rolfz/PICSTAR/Doc/block_diag.jpg

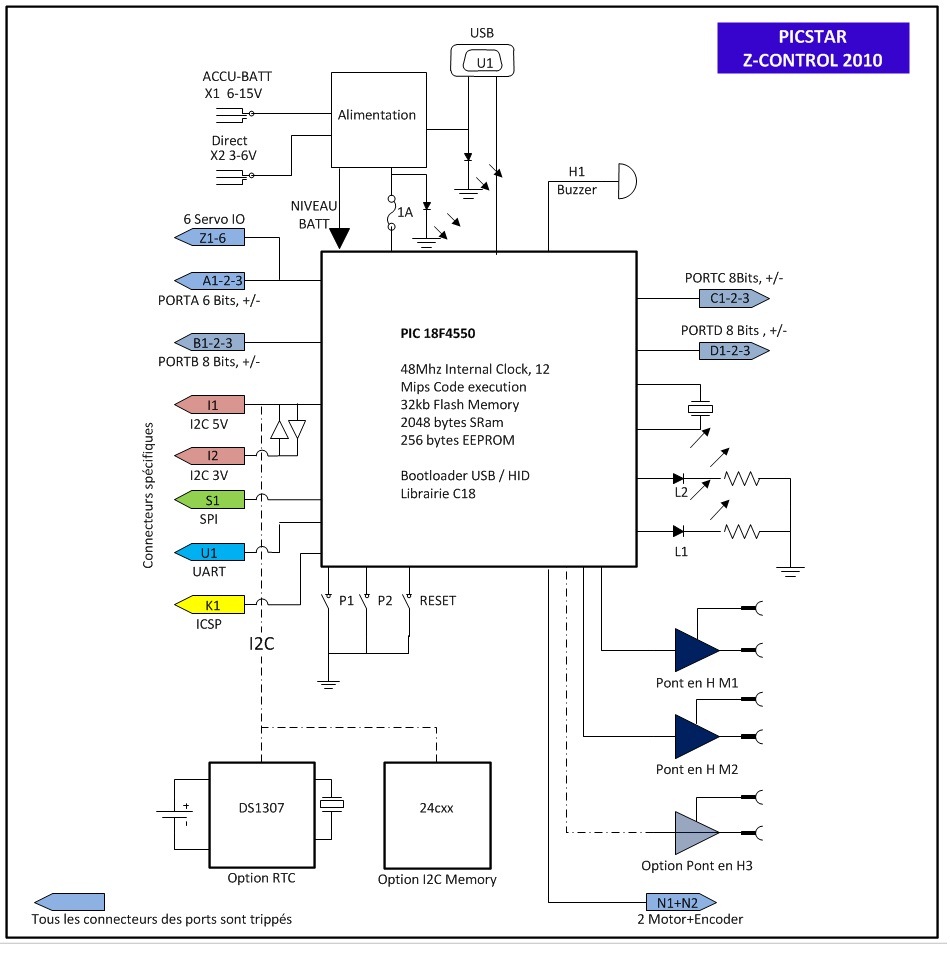
Doc/block_diag.jpg
