rolfz/PICSTAR/Examples/10. RC5 example/RC5_scan.jpg

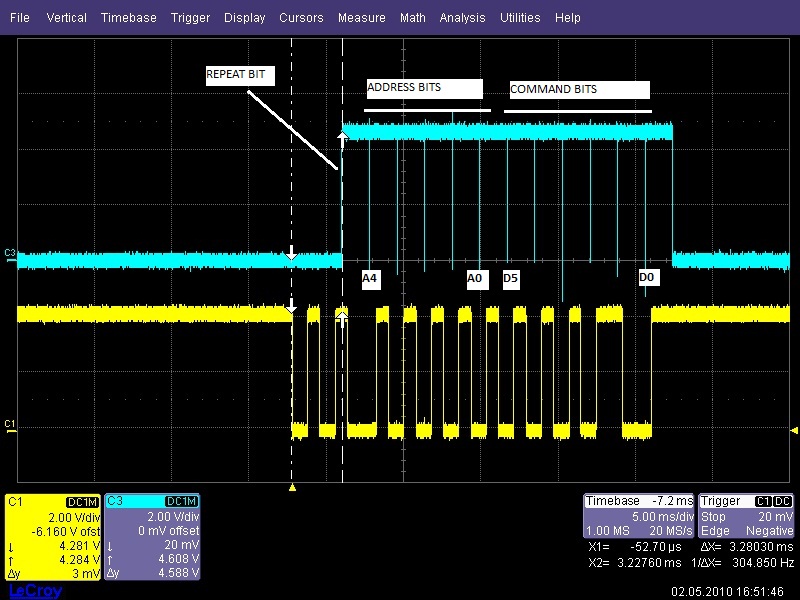
Examples/10. RC5 example/RC5_scan.jpg
