rolfz/PICSTAR/Doc/picstar_schema_det1.1.pdf

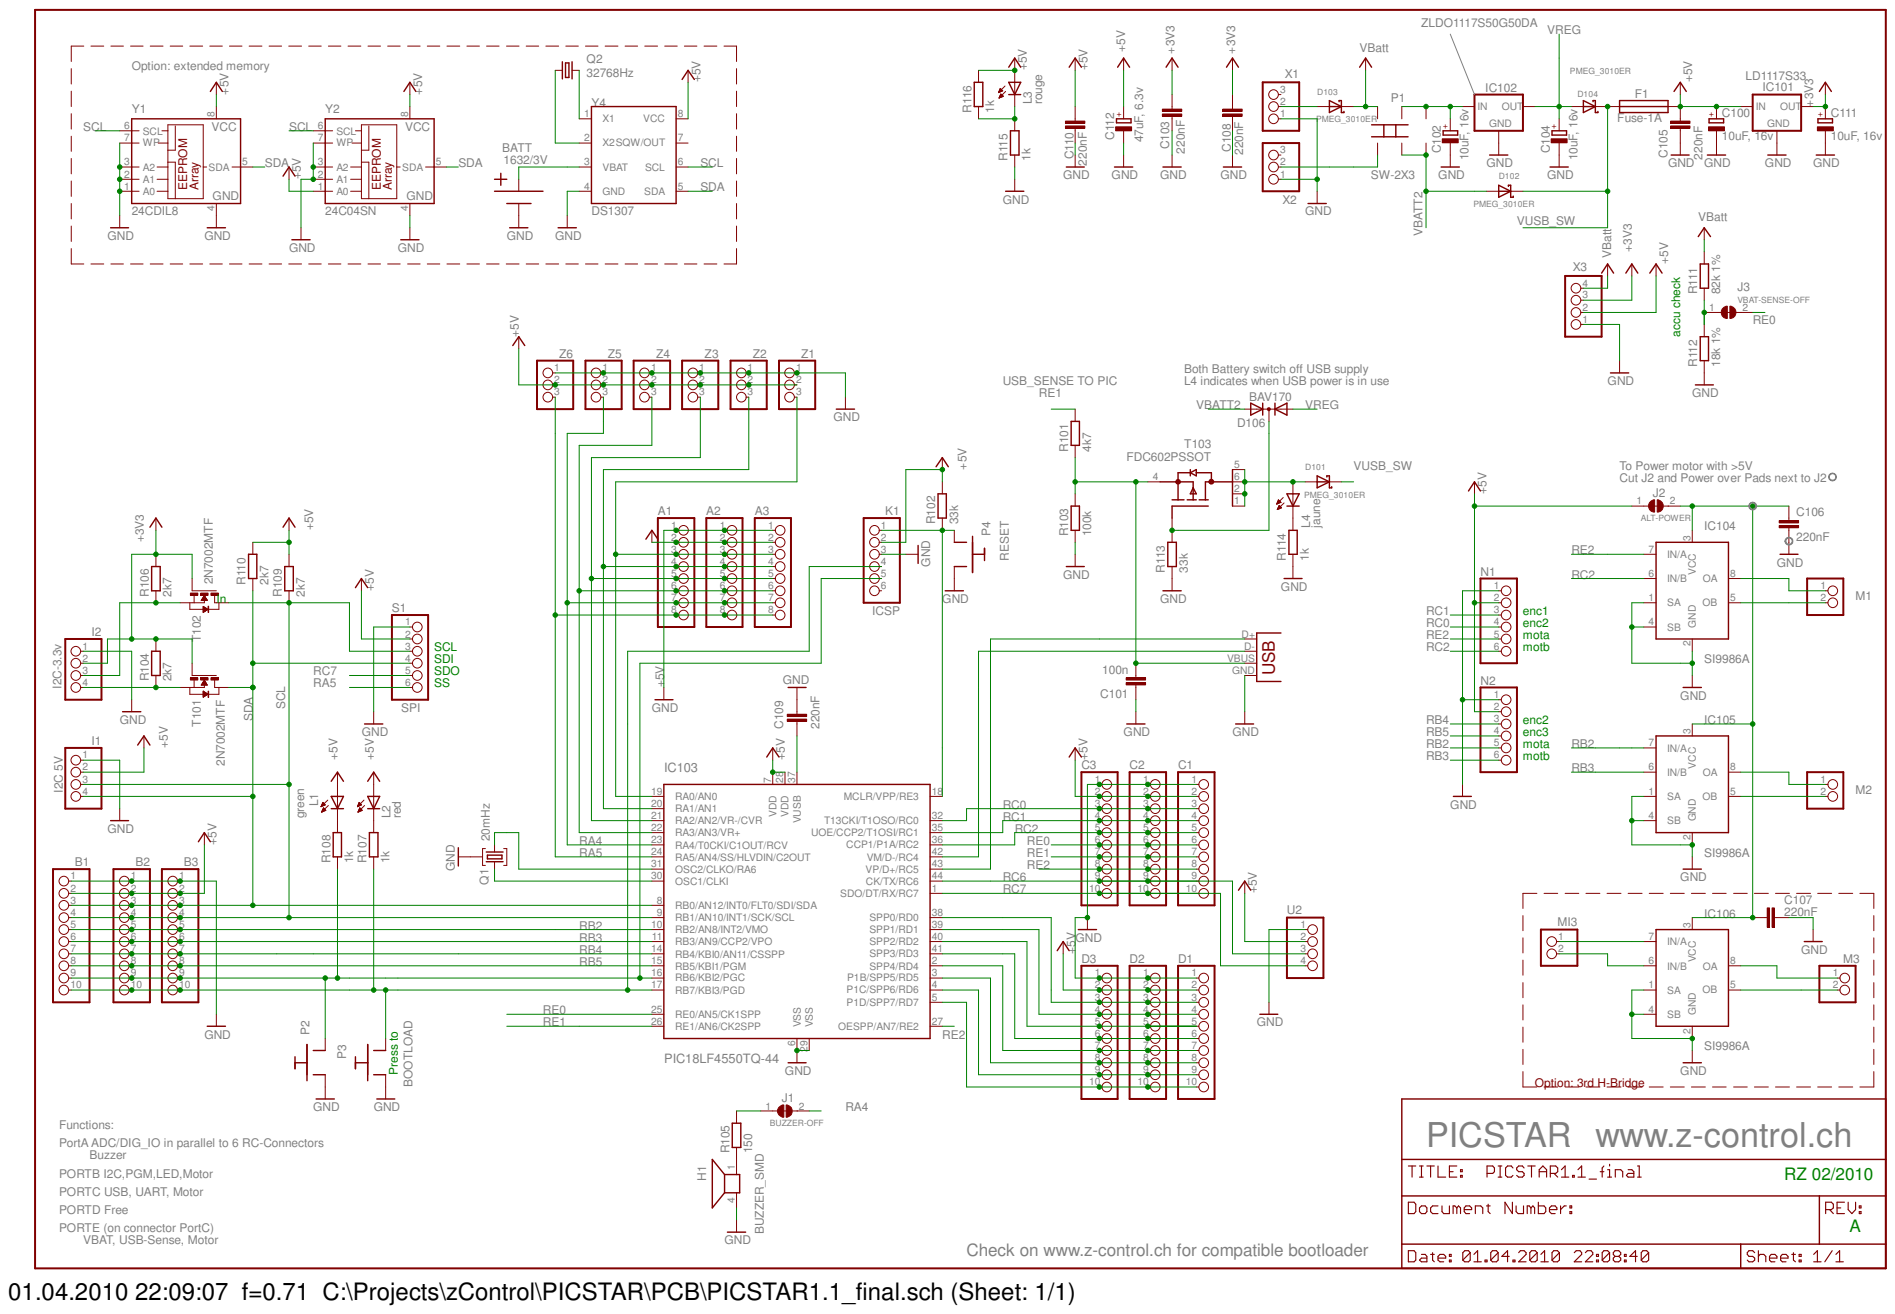
[picture p18: page 1]

Both Battery switch off USB supply
L4 indicates when USB power is in use

To Power motor with >5V
Cut J2 and Power over Pads next to J2

ALT-POWER | IC104

10 | 10 | 10

Functions:
PortA ADC/DIG_IO in parallel to 6 RC-Connectors
Buzzer
PORTB I2C,PGM,LED,Motor
PORTC USB, UART, Motor
PORTD Free
PORTE (on connector PortC)
VBAT, USB-Sense, Motor

Check on www.z-control.ch for compatible bootloader

01.04.2010 22:09:07 f=0.71 C:\Projects\zControl\PICSTAR\PCB\PICSTAR1.1_final.sch (Sheet: 1/1)
