rolfz/PICSTAR/Examples/07. Interrupt example/picstar_int.h

/*

  Name: picstar_int.h
  Title: Interrupt handler for picstar robot project


  By: Rolf Ziegler
  Date: May 2010

  Purpose: Manage all interrupt routines of the project
			this including the time scheduler for various routines
			and other interrupt routines
*/

#ifndef __PICSTARINT
#define __PICSTARINT

void InterruptHandlerHigh (void);
void StepPfm(s8 pfm1,s8 pfm2);

// we need to keep in mind that we run at 12mips
// so every ms we execute 12000 instructions.

void IntRun1ms(void);	// code runs every 1ms
void IntRun10ms(void);	// code runs every 10ms
void IntRun100ms(void);	// code runs every 100ms

s8 Speed_M1=0,Speed_M2=0;
u8 cnt10ms=0;
u8 cnt100ms=0;


//#define ENABLE_INTERRUPT // this will enable the code in the picstar_ini.h file

//----------------------------------------------------------------------------
// High priority interrupt vector

#pragma code InterruptVectorHigh = 0x1008

void 
InterruptVectorHigh (void)
{
  _asm
    goto InterruptHandlerHigh //jump to interrupt routine
  _endasm
}

#pragma code
#pragma interrupt InterruptHandlerHigh

void InterruptHandlerHigh(void)
{
#define OneMS 255-187

  if (INTCONbits.TMR0IF)
    {                                   //check for TMR0 overflow
	  TMR0L=OneMS;  // let's shorten the interrupt time to get 1ms
      INTCONbits.TMR0IF = 0;            //clear interrupt flag

	  IntRun1ms();
    }

// other interrupt service routines can be added here.

}


void Init_Int0(void)
{
  INTCON = 0x20;                //disable global and enable TMR0 interrupt
  INTCON2 = 0x84;               //TMR0 high priority
  RCONbits.IPEN = 1;            //enable priority levels

// timer0 initialisation
  TMR0H = 0;                    //clear timer
  TMR0L = 0;                    //clear timer

// we want a timer0 interrupt of 1ms
  OpenTimer0( TIMER_INT_ON & T0_8BIT & T0_SOURCE_INT  & T0_PS_1_64 );

// to get 1ms we will need to preset the interrupt counter to 187
	// 64(prescale)*187(timer0 counter)*1/12mhz= .9973ms

// enable interrupt can be added in main code
//  INTCONbits.GIEH = 1;

}

#endif
